Miceuz/thermocouple-modbus/README.md

thermocouple-modbus
===================

Thermocouple frontend accessible via industrial modbus protocol
