Miceuz/thermocouple-modbus/Termoporos keisas3d.JPG

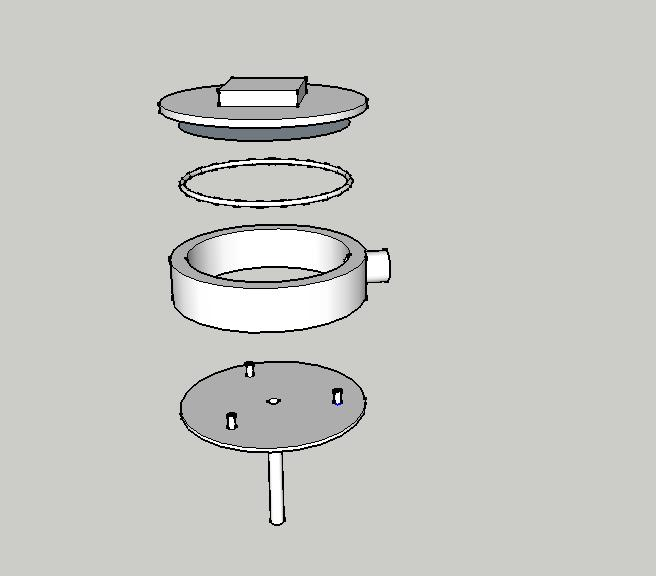
Termoporos keisas3d.JPG
