Miceuz/thermocouple-modbus/thermocouple2.png

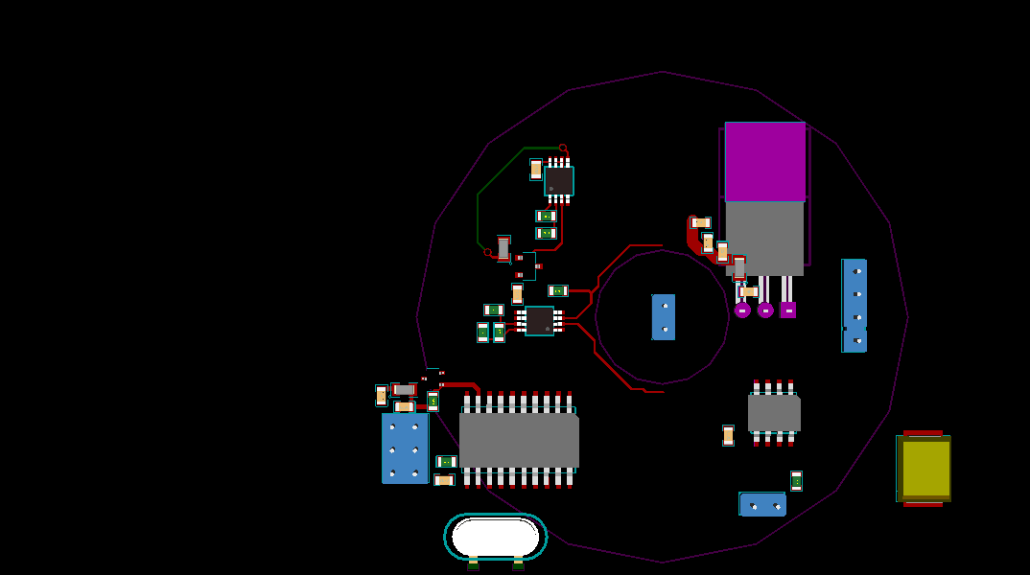
thermocouple2.png
