Miceuz/thermocouple-modbus/thermocouple3-1.png

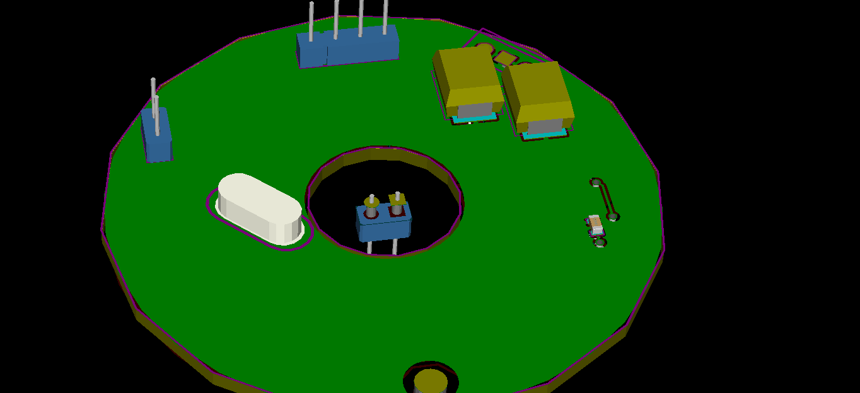
thermocouple3-1.png
