Miceuz/thermocouple-modbus/thermocouple3.png

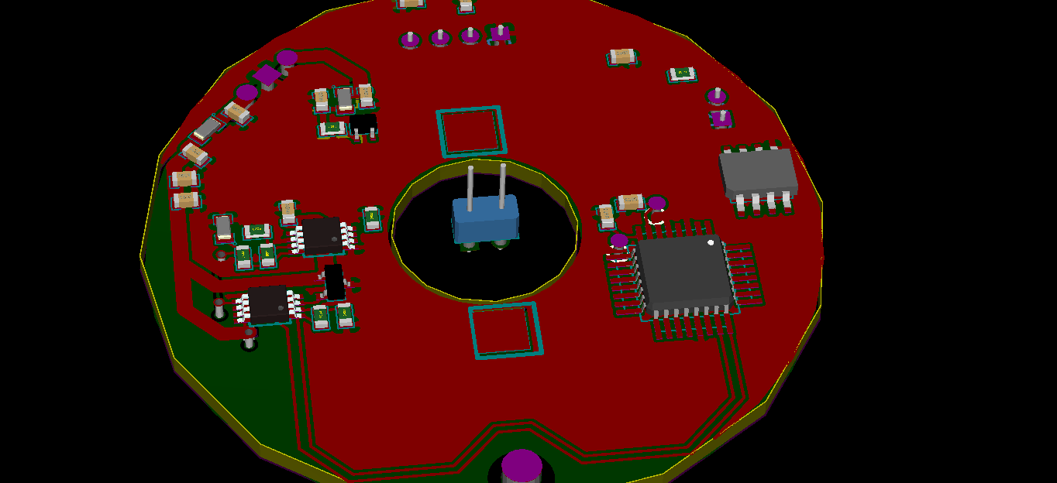
thermocouple3.png
