Miceuz/thermocouple-modbus/thermocouple4-1.png

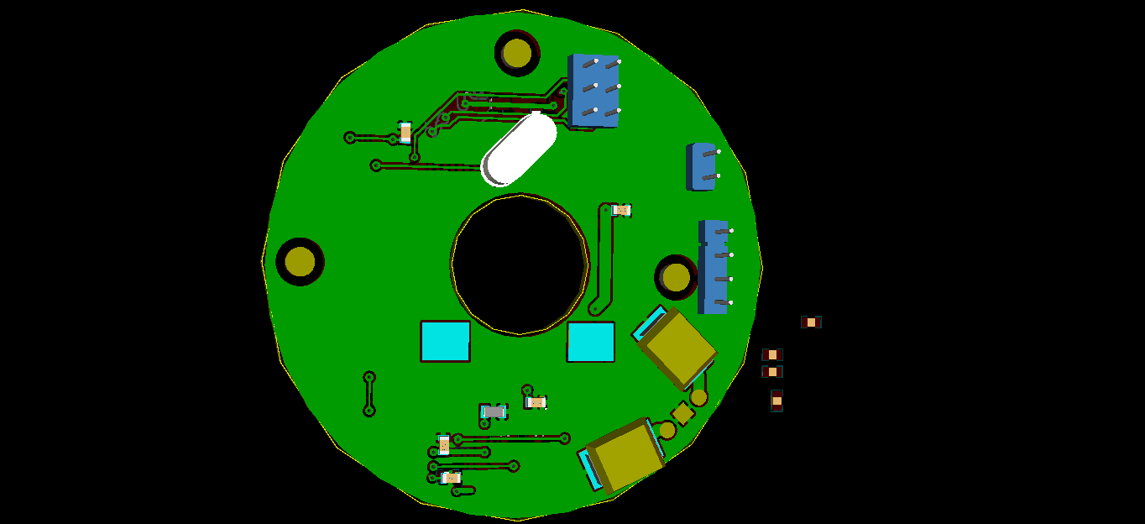
thermocouple4-1.png
