Miceuz/thermocouple-modbus/thermocouple4.png

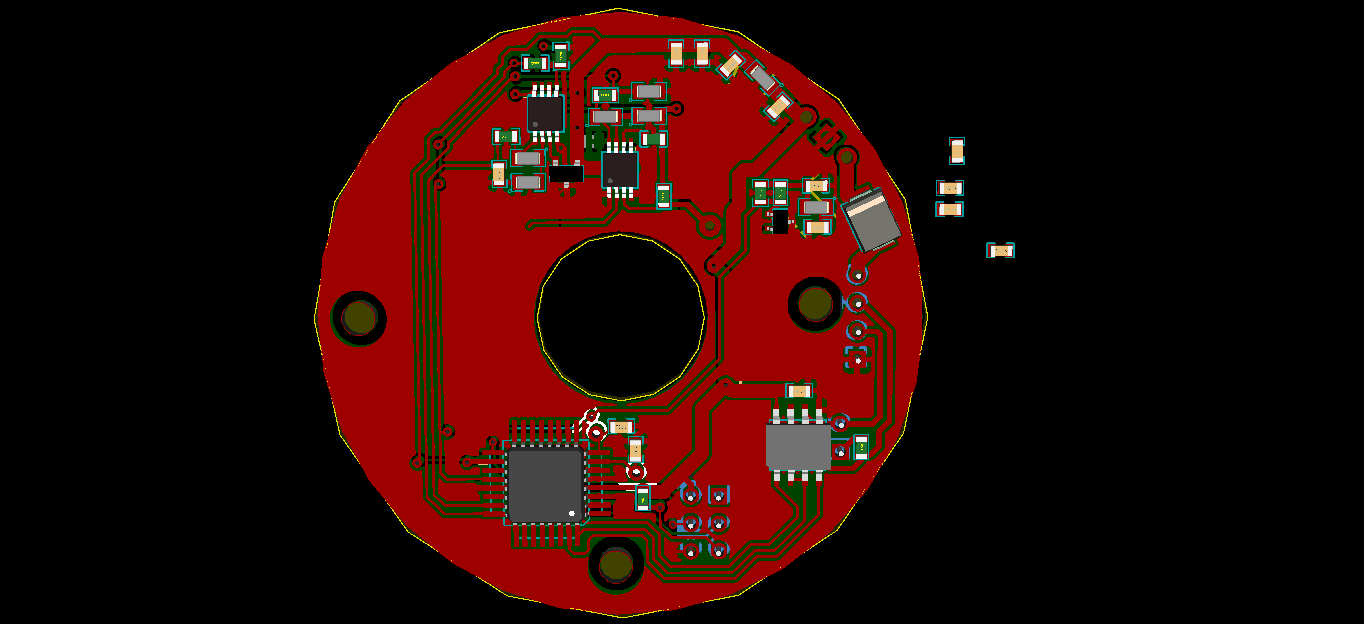
thermocouple4.png
