Miceuz/thermocouple-modbus/thermocouple5-1.png

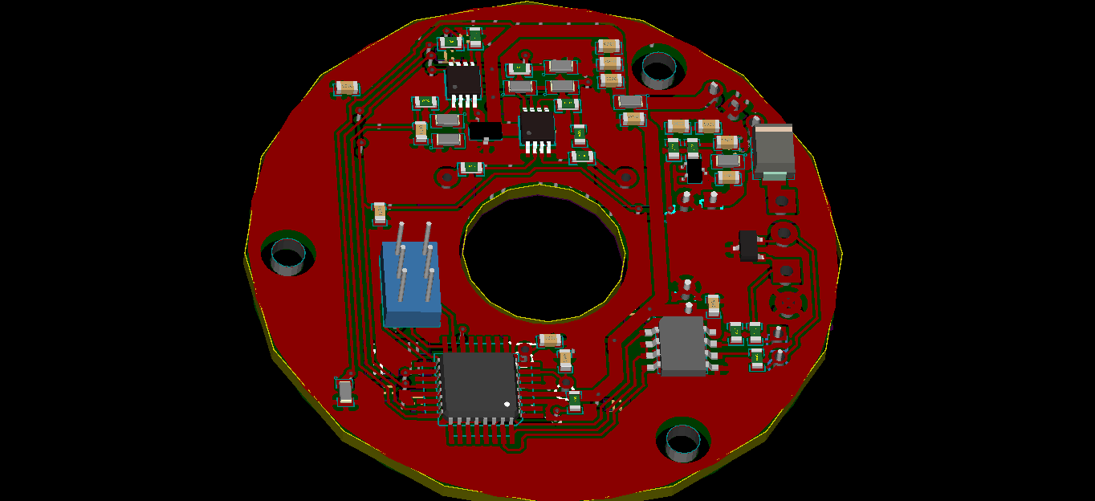
thermocouple5-1.png
