Miceuz/thermocouple-modbus/thermocouple5.png

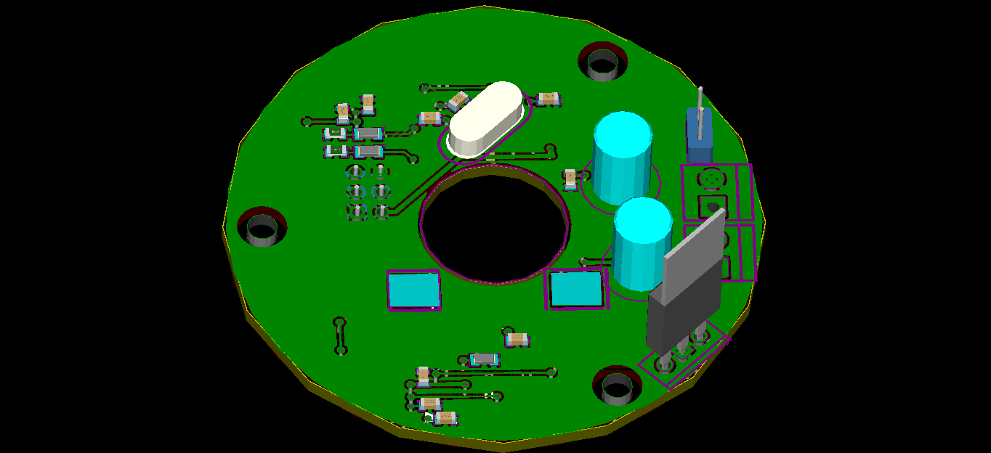
thermocouple5.png
