Miceuz/thermocouple-modbus/thermocouple.png

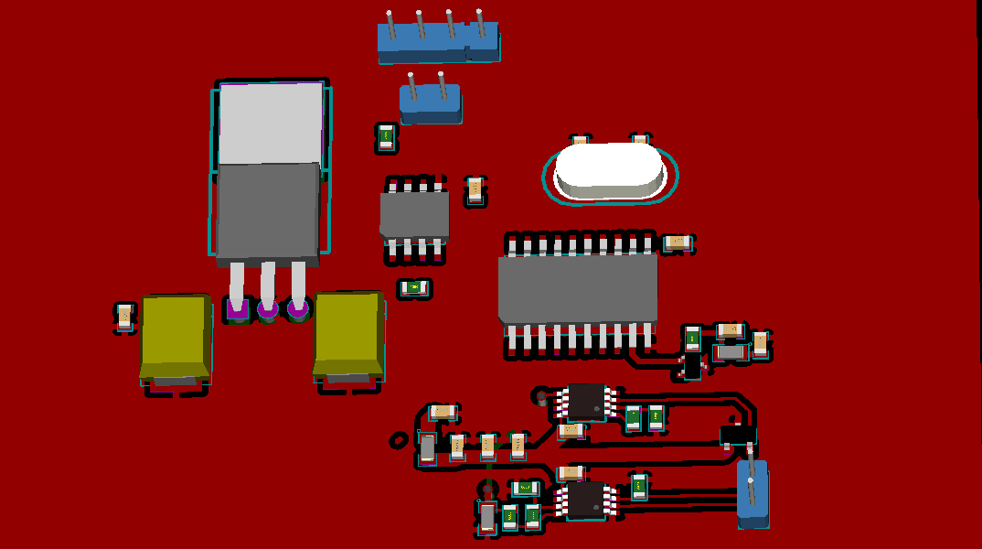
thermocouple.png
