Miceuz/thermocouple-modbus/(list of files, cad)

Other CAD files:
termoporos baranka.dwg
termoporos keisas.skp
