Miceuz/thermocouple-modbus/thermocouple.pdf

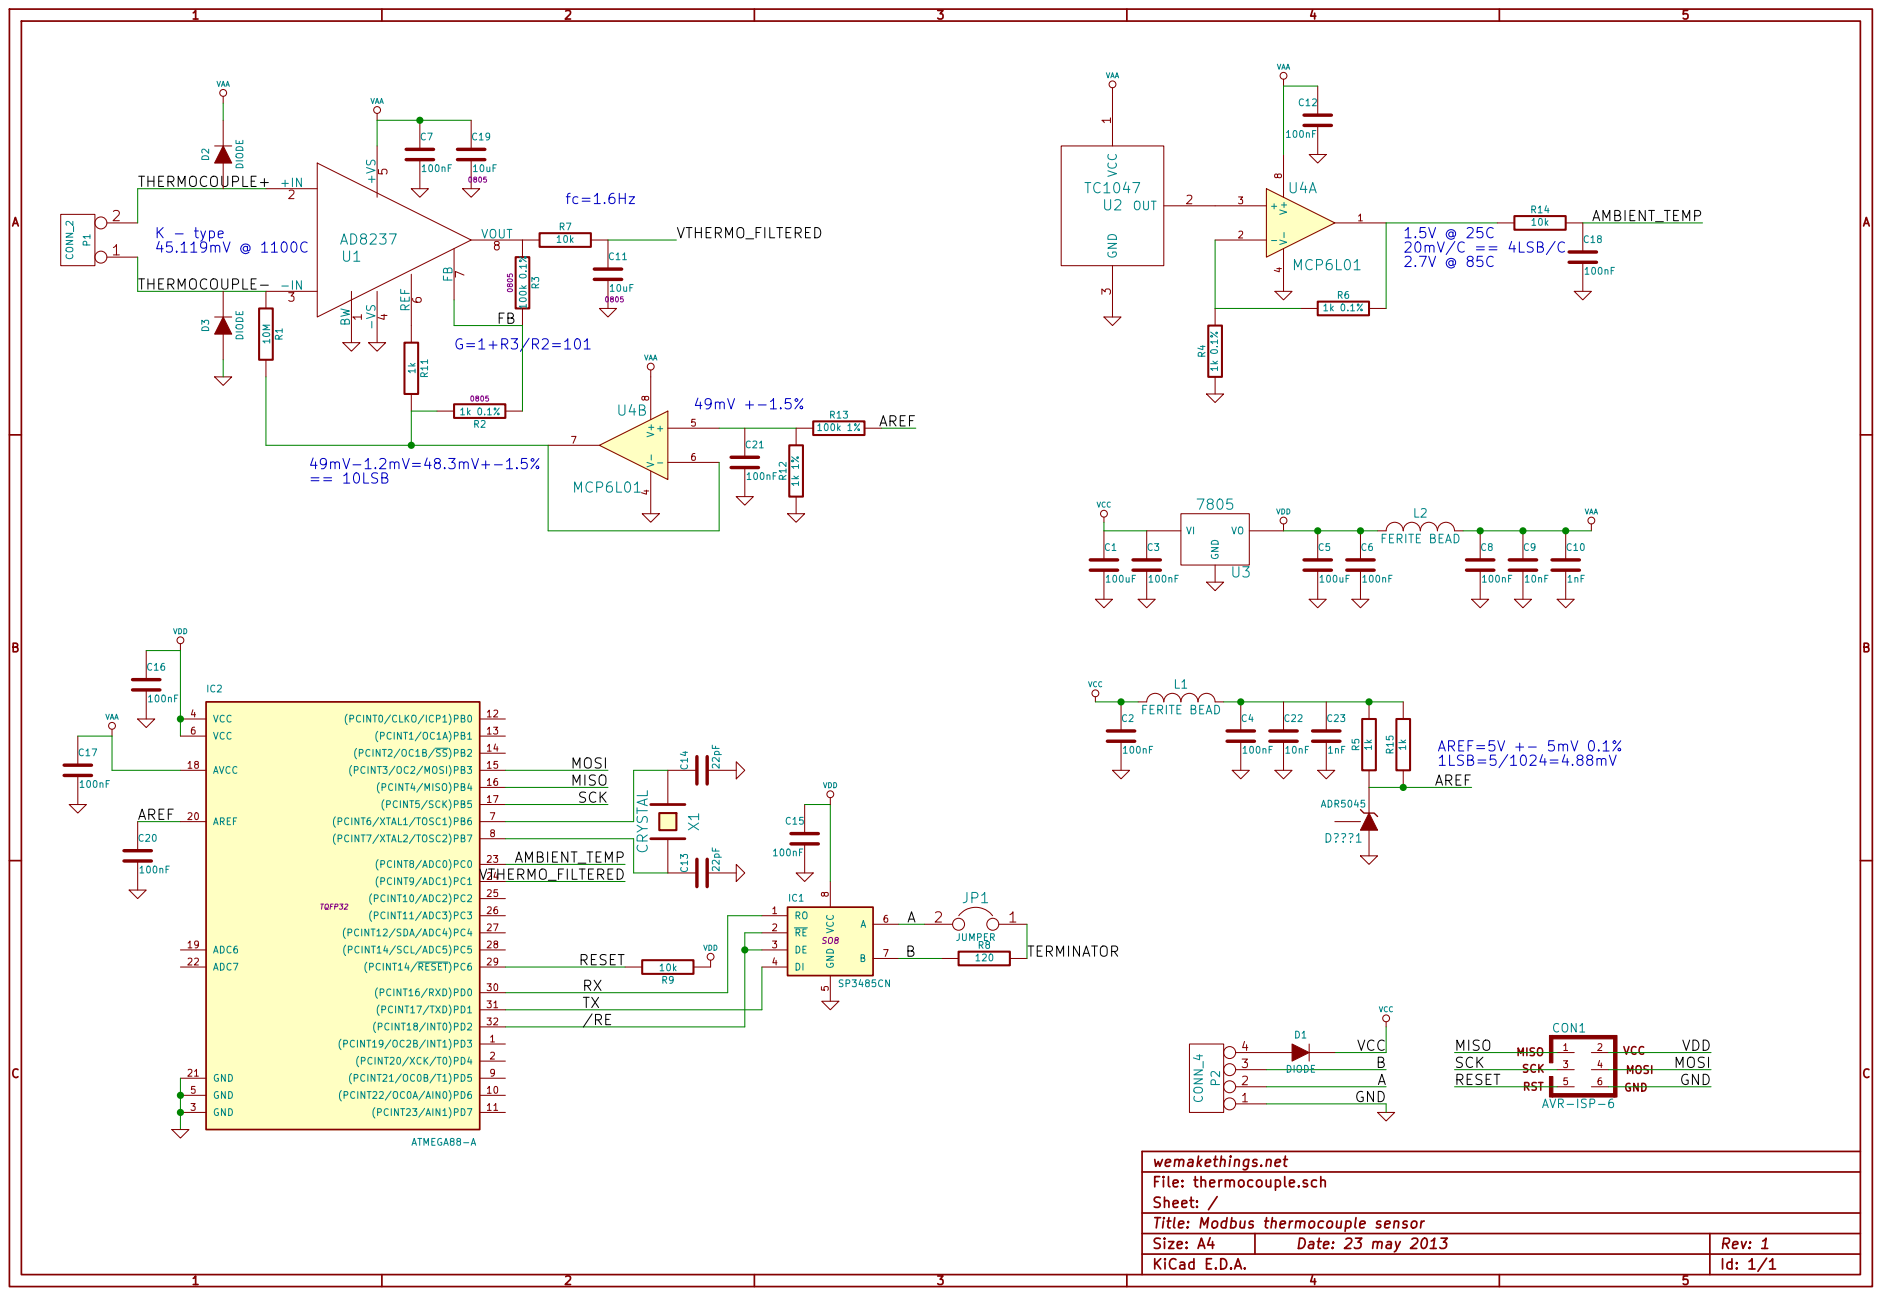
[picture p10: page 1]

File: thermocouple.sch
Sheet: /
Title: Modbus thermocouple sensor
KiCad E.D.A.
