Miceuz/thermocouple-modbus/termoporos baranka.pdf

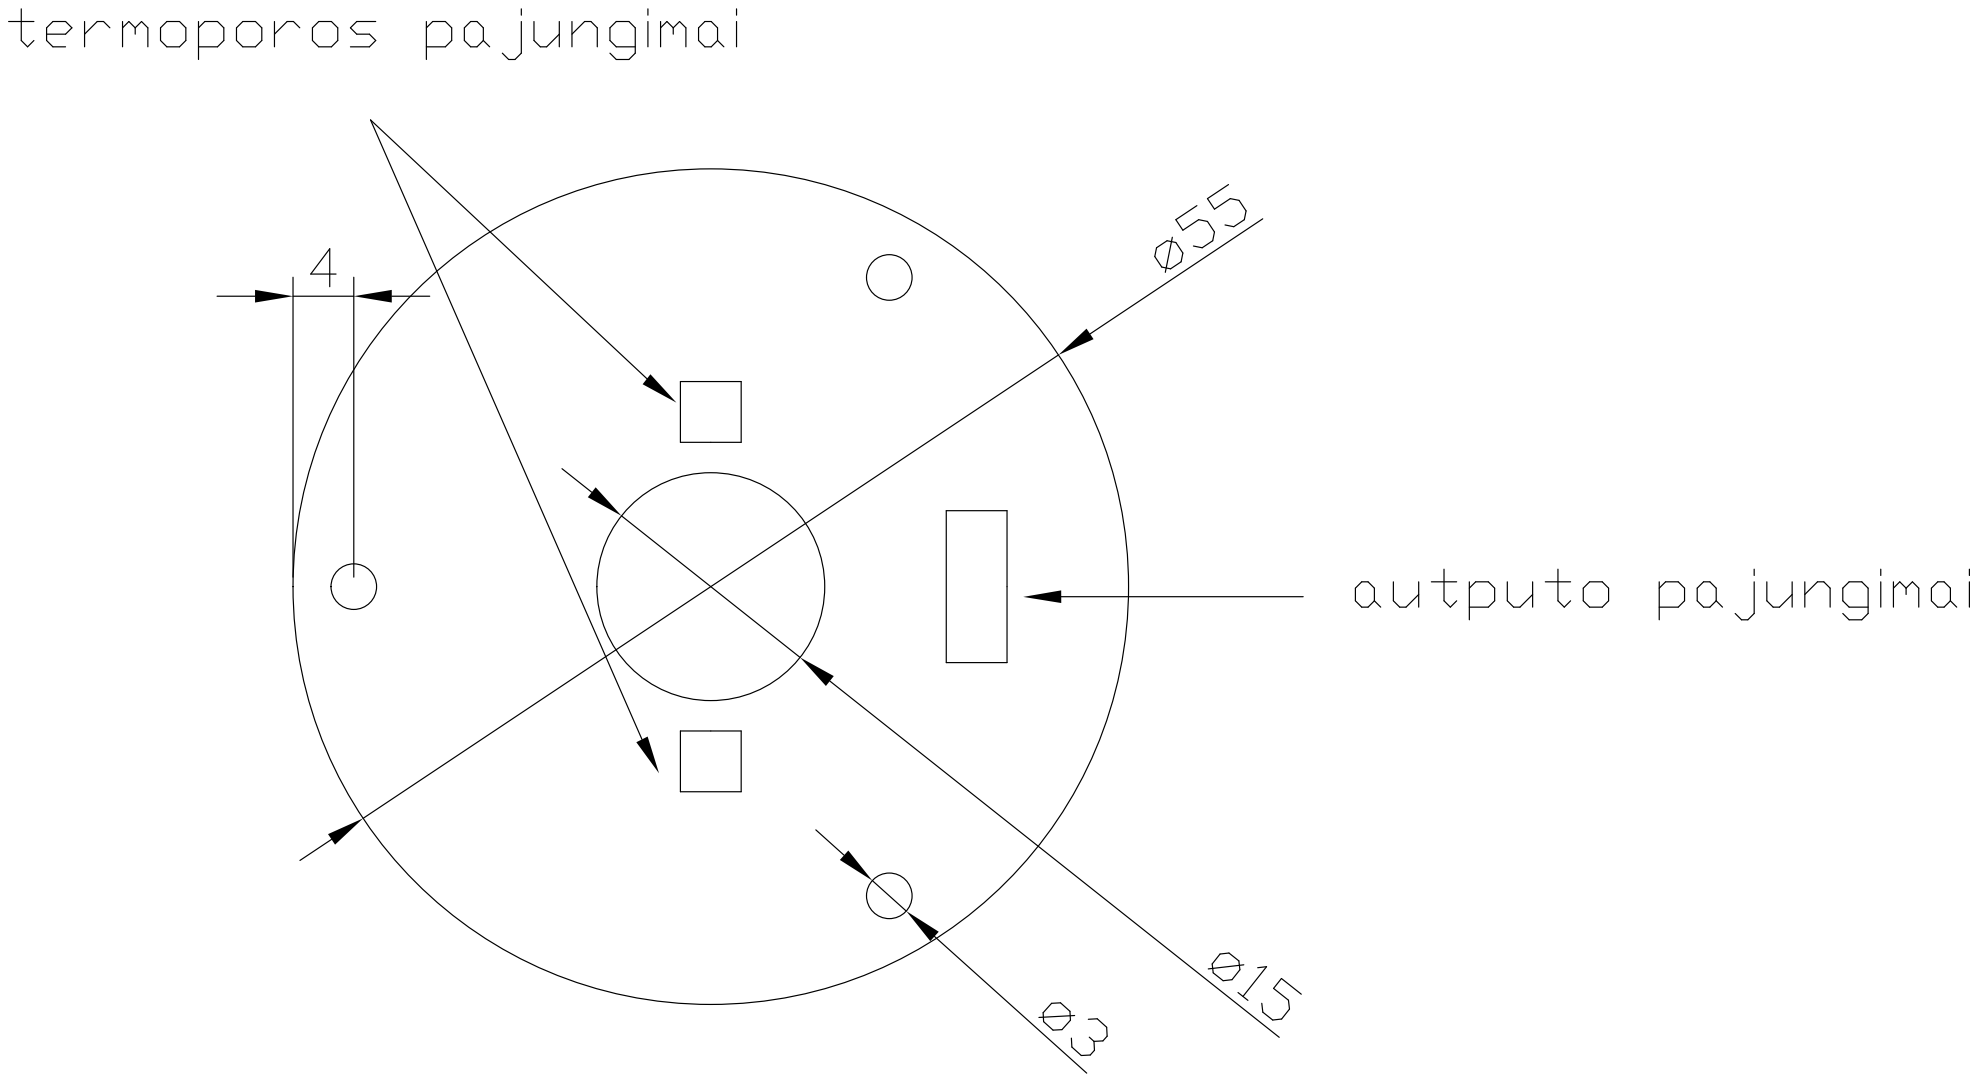
[picture p11: page 1]
