Miceuz/thermocouple-modbus/thermocouple.kicad_pcb

## KiCad design thermocouple.kicad_pcb (2013-10-27)

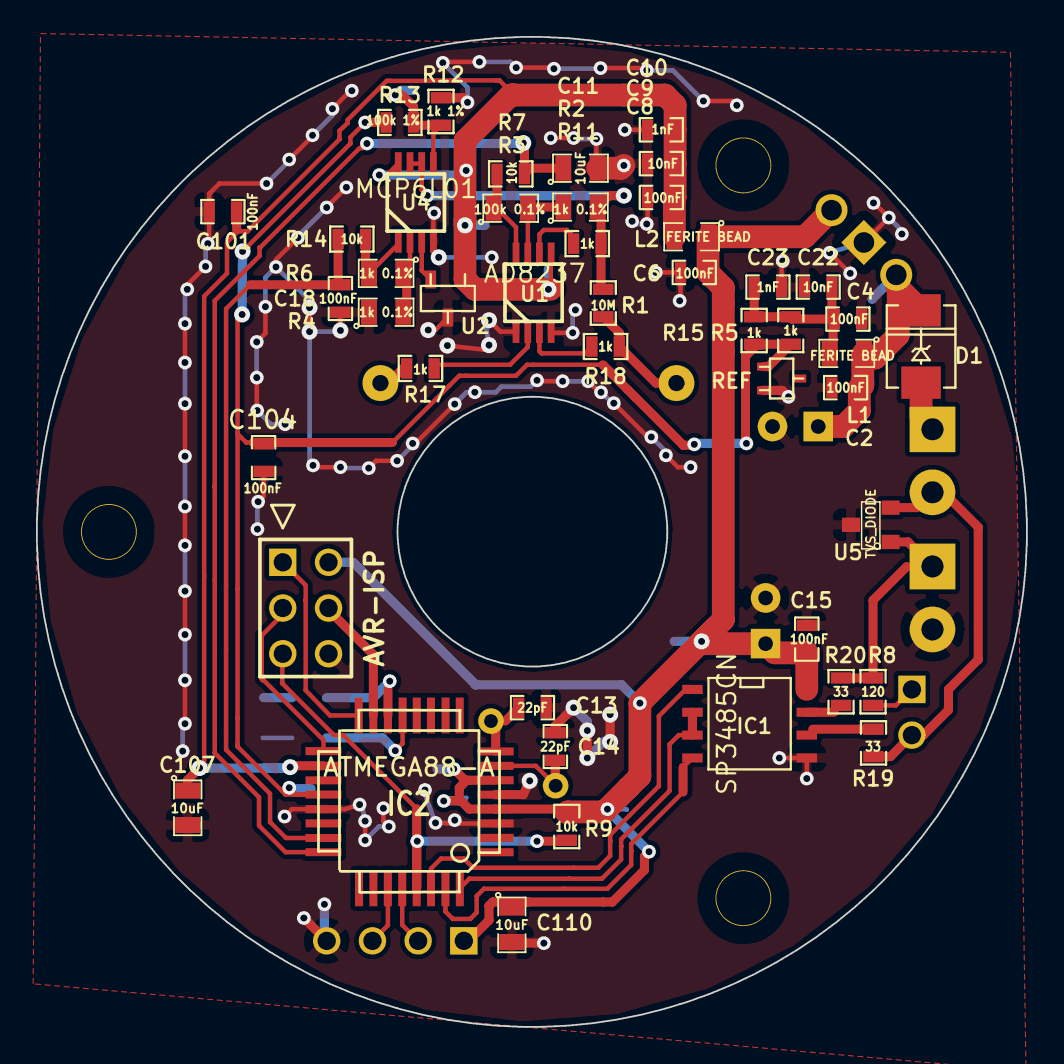
[picture p12: board thermocouple.kicad_pcb from above]

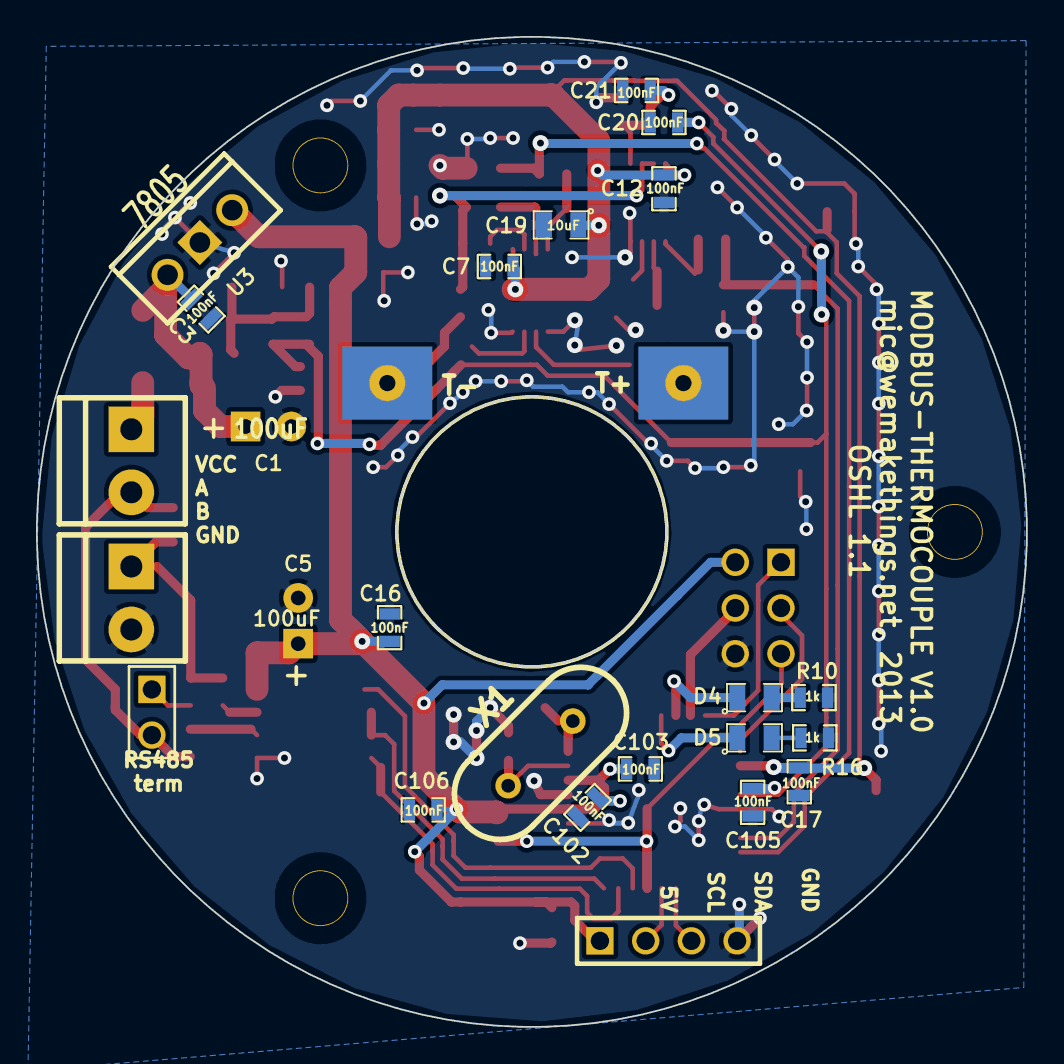
[picture p13: board thermocouple.kicad_pcb from below]

Board: 2 copper layers, 55.0 x 55.0 mm, 68 parts (22 on the bottom side), 37 nets.

Parts:
AVR-ISP: AVR-ISP-6; pin_array_3x2
C1, C5: 100uF; C1V8
C2, C3, C4, C6, C7, C8, C12, C15, C16, C17, C18, C20, C21, C101, C102, C103, C104, C105, C106: 100nF; SM0603_Capa
C9, C22: 10nF; SM0603_Capa
C10, C23: 1nF; SM0603_Capa
C11, C19, C107, C110: 10uF; SM0805
C13, C14: 22pF; SM0603_Capa
D1: DO-214AA(SMB)
D4, D5: SM0805
IC1: SP3485CN; SO8N
IC2: ATMEGA88-A; TQFP32
L1, L2: FERITE BEAD; SM0805
R1: 10M; SM0603_Resistor
R2, R4, R6: 1k 0.1%; SM0805
R3: 100k 0.1%; SM0805
R5, R10, R11, R15, R16, R17, R18: 1k; SM0603_Resistor
R7, R9, R14: 10k; SM0603_Resistor
R8: 120; SM0603_Resistor
R12: 1k 1%; SM0603_Resistor
R13: 100k 1%; SM0603_Resistor
R19, R20: 33; SM0603_Resistor
REF: ADR5045; sc70
T+: 1PIN_SMD
T-: 1PIN_SMD
U1: AD8237; MSOP_8
U2: TC1047; sot23
U3: 7805; LM78XXV
U4: MCP6L01; MSOP_8
U5: TVS_DIODE; SOT23
X1: HC-49V

Connections:
//RE: IC1.2, IC1.3, IC2.32
/A: R19.1, U5.2
/AMBIENT_TEMP: C18.1, IC2.23, R14.2
/AREF: C20.1, C104.1, C105.1, IC2.20, R5.1, R13.2, R15.1, REF.1
/B: R8.2, R20.1, U5.1
/FB: R2.1, R3.2, U1.7
/MISO: AVR-ISP.1, IC2.16
/MOSI: AVR-ISP.4, IC2.15
/RESET: AVR-ISP.5, IC2.29, R9.2
/RX: IC1.1, IC2.30
/SCK: AVR-ISP.3, IC2.17
/THERMOCOUPLE+: R17.1, T+.1
/THERMOCOUPLE-: R1.1, R18.1, T-.1, T-.2
/TX: IC1.4, IC2.31
/VTHERMO_FILTERED: C11.1, IC2.24, R7.2
GND: AVR-ISP.6, C1.2, C2.2, C3.2, C4.2, C5.2, C6.2, C7.2, C8.2, C9.2, C10.2, C11.2, C12.2, C13.2, C14.2, C15.2, C16.2, C17.2, C18.2, C19.2, C20.2, C21.2, C22.2, C23.2, C101.2, C102.2, C103.2, C104.2, C105.2, C106.2, C107.2, C110.2, IC1.5, IC2.3, IC2.5, IC2.21, R4.1, R10.2, R12.1, R16.2, REF.2, U1.1, U1.4, U2.3, U3.GND, U4.4, U5.3
unnamed: D4.2, R10.1
unnamed: D5.2, R16.1
unnamed: R17.2, U1.2
unnamed: C21.1, R12.2, R13.1, U4.5
unnamed: R6.2, R14.1, U4.1
unnamed: R4.2, R6.1, U4.2
unnamed: R18.2, U1.3
unnamed: R11.1, U1.6
unnamed: D4.1, IC2.14
unnamed: D5.1, IC2.13
unnamed: R1.2, R2.2, R11.2, U4.6, U4.7
unnamed: IC1.7, R20.2
unnamed: IC1.6, R19.2
unnamed: C13.1, IC2.8, X1.2
unnamed: C14.1, IC2.7, X1.1
unnamed: R3.1, R7.1, U1.8
unnamed: U2.2, U4.3
unnamed: C4.1, C22.1, C23.1, L1.2, R5.2, R15.2
VAA: C7.1, C8.1, C9.1, C10.1, C12.1, C17.1, C19.1, C101.1, C107.1, IC2.18, L2.2, U1.5, U2.1, U4.8
VCC: C1.1, C2.1, C3.1, D1.2, L1.1, U3.VI
VDD: AVR-ISP.2, C5.1, C6.1, C15.1, C16.1, C102.1, C103.1, C106.1, C110.1, IC1.8, IC2.4, IC2.6, L2.1, R9.1, U3.VO
