Miceuz/thermocouple-modbus/thermocouple-attiny1634.kicad_pcb

## KiCad design thermocouple-attiny1634.kicad_pcb (2013-05-18)

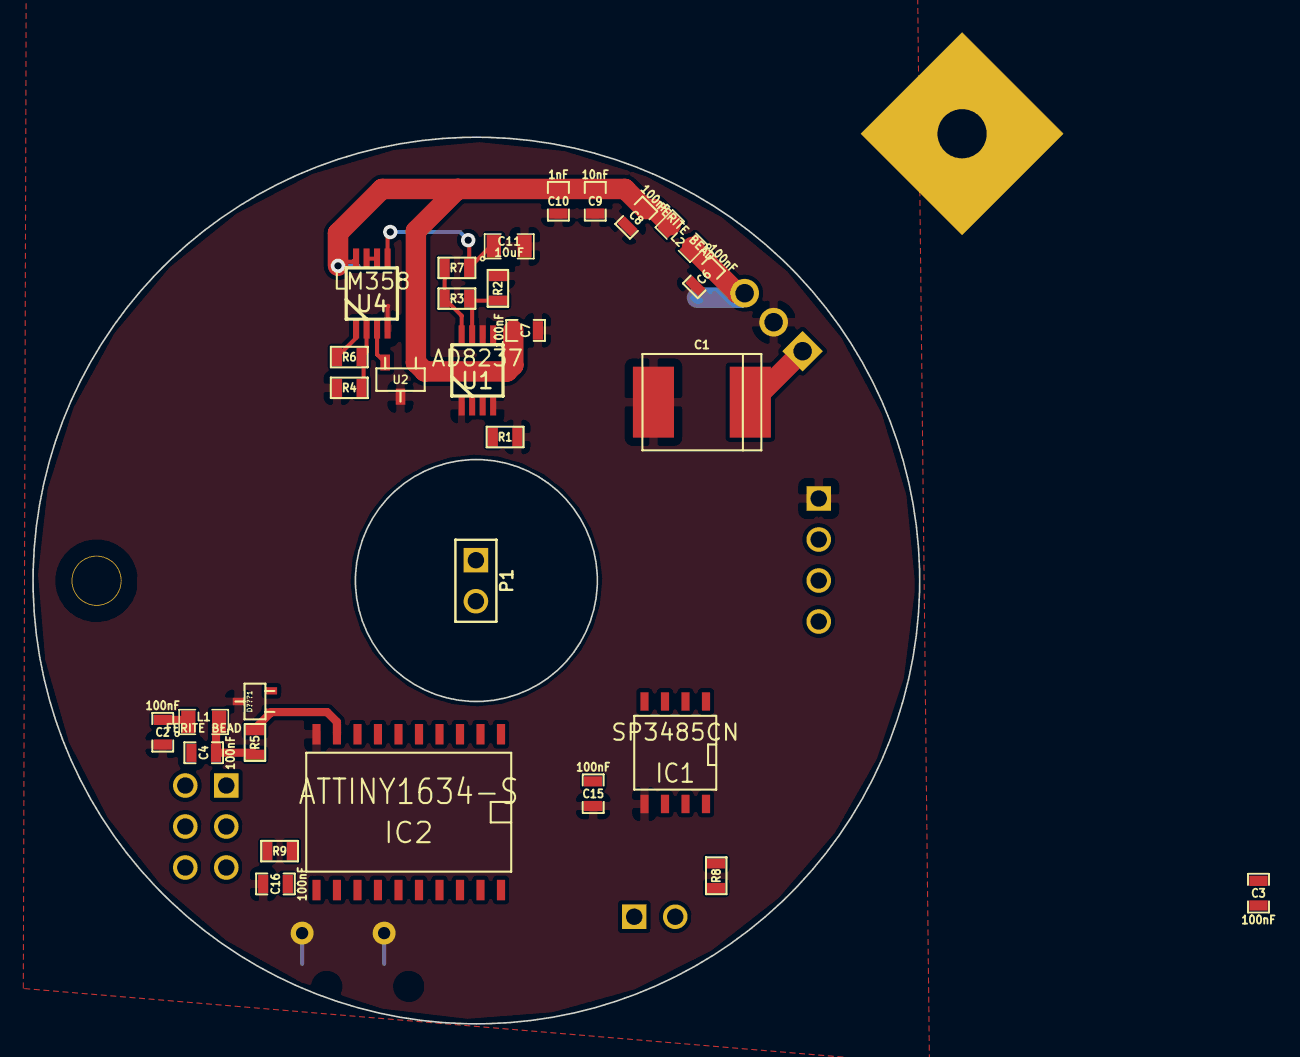
[picture p14: board thermocouple-attiny1634.kicad_pcb from above]

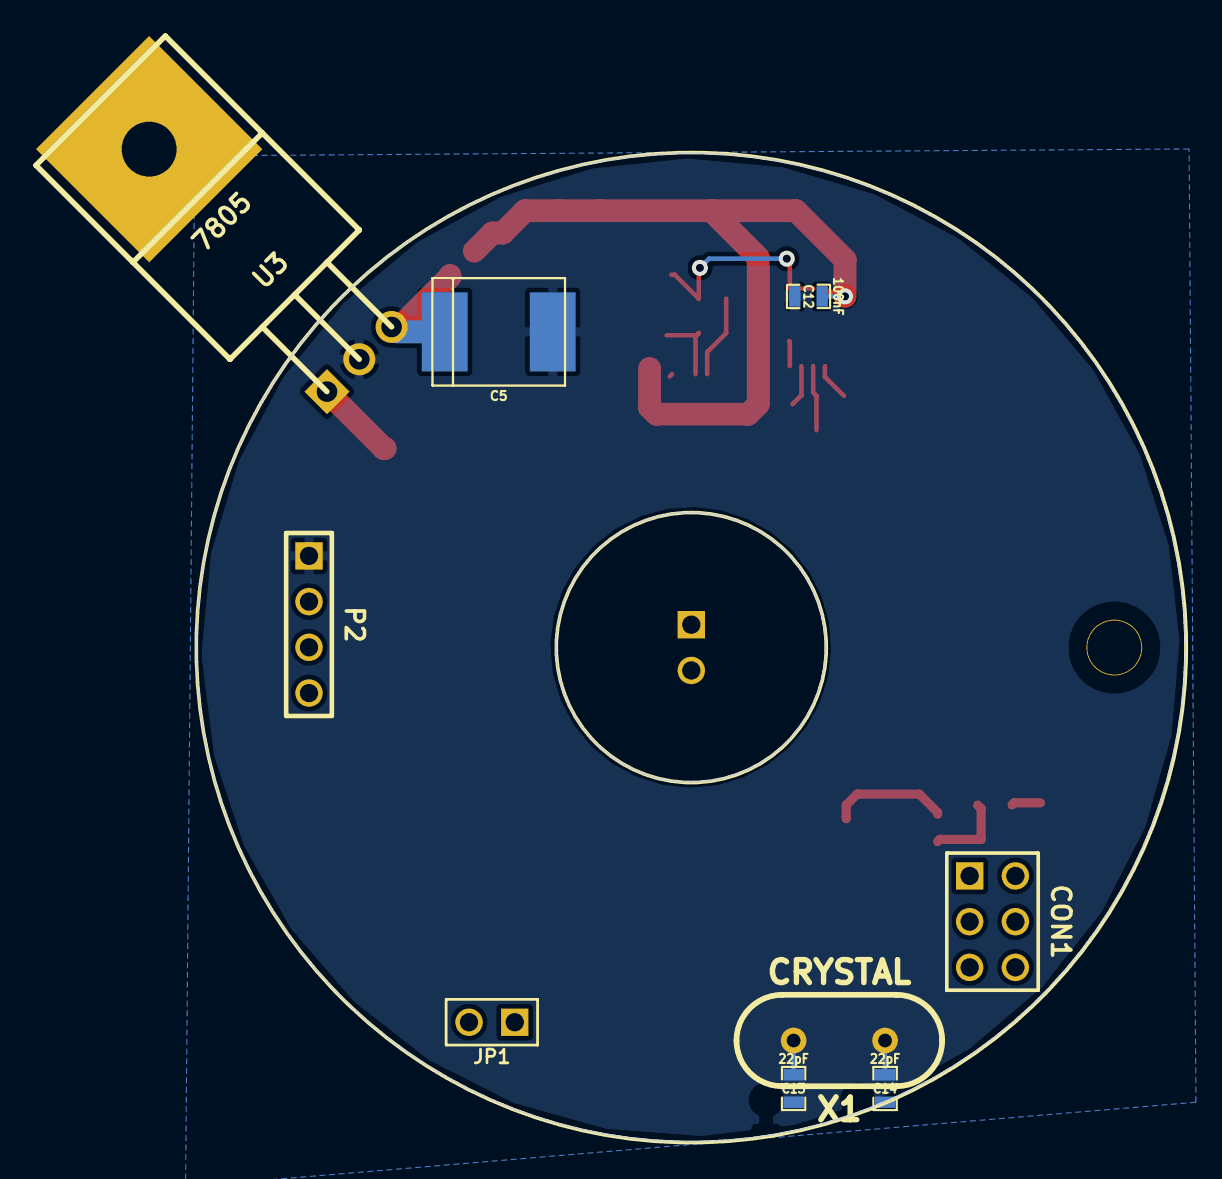
[picture p15: board thermocouple-attiny1634.kicad_pcb from below]

Board: 2 copper layers, 54.9 x 54.9 mm, 39 parts (9 on the bottom side), 24 nets.

Parts:
C1, C5: 100uF; c_tant_E
C2, C3, C4, C6, C7, C8, C12, C15, C16: 100nF; SM0603_Capa
C9: 10nF; SM0603_Capa
C10: 1nF; SM0603_Capa
C11: 10uF; SM0805
C13, C14: 22pF; SM0603_Capa
CON1: AVR-ISP-6; pin_array_3x2
D???1: ADR5045; sc70
IC1: SP3485CN; SO8N
IC2: ATTINY1634-S; SO20L
JP1: JUMPER; PIN_ARRAY_2X1
L1, L2: FERITE BEAD; SM0805
P1: CONN_2; PIN_ARRAY_2X1
P2: CONN_4; PIN_ARRAY_4x1
R1: 10M; SM0603
R2, R3, R5: R; SM0603
R4, R6: 1k; SM0603
R7: 10k; SM0603
R8, R9: 120; SM0603
U1: AD8237; MSOP_8
U2: TC1047; sot23
U3: 7805; TO220
U4: LM358; MSOP_8
X1: CRYSTAL; HC-49V

Connections:
//RE: IC1.2, IC1.3, IC2.3
/A: IC1.6, JP1.2, P2.3
/AMBIENT_TEMP: IC2.6, R6.2, U4.1
/AREF: D???1.1, IC2.9, R5.1
/B: IC1.7, P2.2, R8.2
/FB: R2.2, R3.2, U1.7
/RX: IC1.1, IC2.2
/TERMINATOR: JP1.1, R8.1
/THERMOCOUPLE+: P1.2, U1.2
/THERMOCOUPLE-: P1.1, R1.1, U1.3
/TX: IC1.4, IC2.1
/VTHERMO_BUFFERED: IC2.5, U4.6, U4.7
/VTHERMO_FILTERED: C11.1, R7.2, U4.5
GND: C1.2, C2.2, C3.2, C4.2, C5.2, C6.2, C7.2, C8.2, C9.2, C10.2, C11.2, C12.2, C13.2, C14.2, C15.2, C16.2, D???1.2, IC1.5, IC2.10, P2.1, R1.2, R2.1, R4.1, U1.1, U1.4, U1.6, U2.3, U3.2, U3.4, U4.4
unnamed: R4.2, R6.1, U4.2
unnamed: IC2.14, R9.1
unnamed: C4.1, L1.2, R5.2
unnamed: C13.1, IC2.13, X1.2
unnamed: C14.1, IC2.12, X1.1
unnamed: U2.2, U4.3
unnamed: R3.1, R7.1, U1.8
VAA: C7.1, C8.1, C9.1, C10.1, C12.1, L2.2, U1.5, U2.1, U4.8
VCC: C1.1, C2.1, C3.1, L1.1, P2.4, U3.1
VDD: C5.1, C6.1, C15.1, C16.1, IC2.11, L2.1, R9.2, U3.3
