Miceuz/thermocouple-modbus/(commit log)

2013-05-18 visko daug
    [thermocouple-attiny1634.kicad_pcb, thermocouple-attiny1634.sch, thermocouple.kicad_pcb]
2013-05-18 and mechanical drawings? and mechanical drawings.
    [termoporos baranka.dwg, termoporos keisas.skp]
2013-05-24 suddenly everything went better than expected
    [thermocouple.kicad_pcb, thermocouple.sch]
2013-05-25 almost there
    [thermocouple.kicad_pcb, thermocouple.sch]
2013-05-26 RS485 protection added
    [$thermocouple.sch, thermocouple.kicad_pcb]
2013-05-26 more stuff
    [thermocouple.kicad_pcb, thermocouple.sch]
2013-06-10 still fiddling around
    [thermocouple.kicad_pcb, thermocouple.sch]
2013-10-27 testing and calibration was going on
    [$thermocouple.sch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]
2014-04-02 Tune up fixed point calculation constants to get max accuracy
    [main.c]
2014-04-02 add more fixed point math comments
    [main.c]
2014-04-21 add I2C master driver from RP6 project
2014-04-21 ok, we can speek to TriacBloc via I2C
2014-04-21 ant the naivest possible PID works
2014-04-22 slow pid setting
2014-04-27 run timer in CTC mode, avoid manually reseting timer to 0. Now sampling frequency looks to be right
    [adc.c]
2014-04-27 run timer2 to generate triangle wave at frequency fsampling/16. this triangle wave is being added to measured signal
2014-04-28 PID library refactored
2014-04-28 refactor code a bit, extract adc to temperature conversion to separate function
